PickledDog/matx-pc104/README.md

# matx-pc104
 microATX carrier board for PC/104 SBCs
