PickledDog/matx-pc104/matx-pc104.pdf

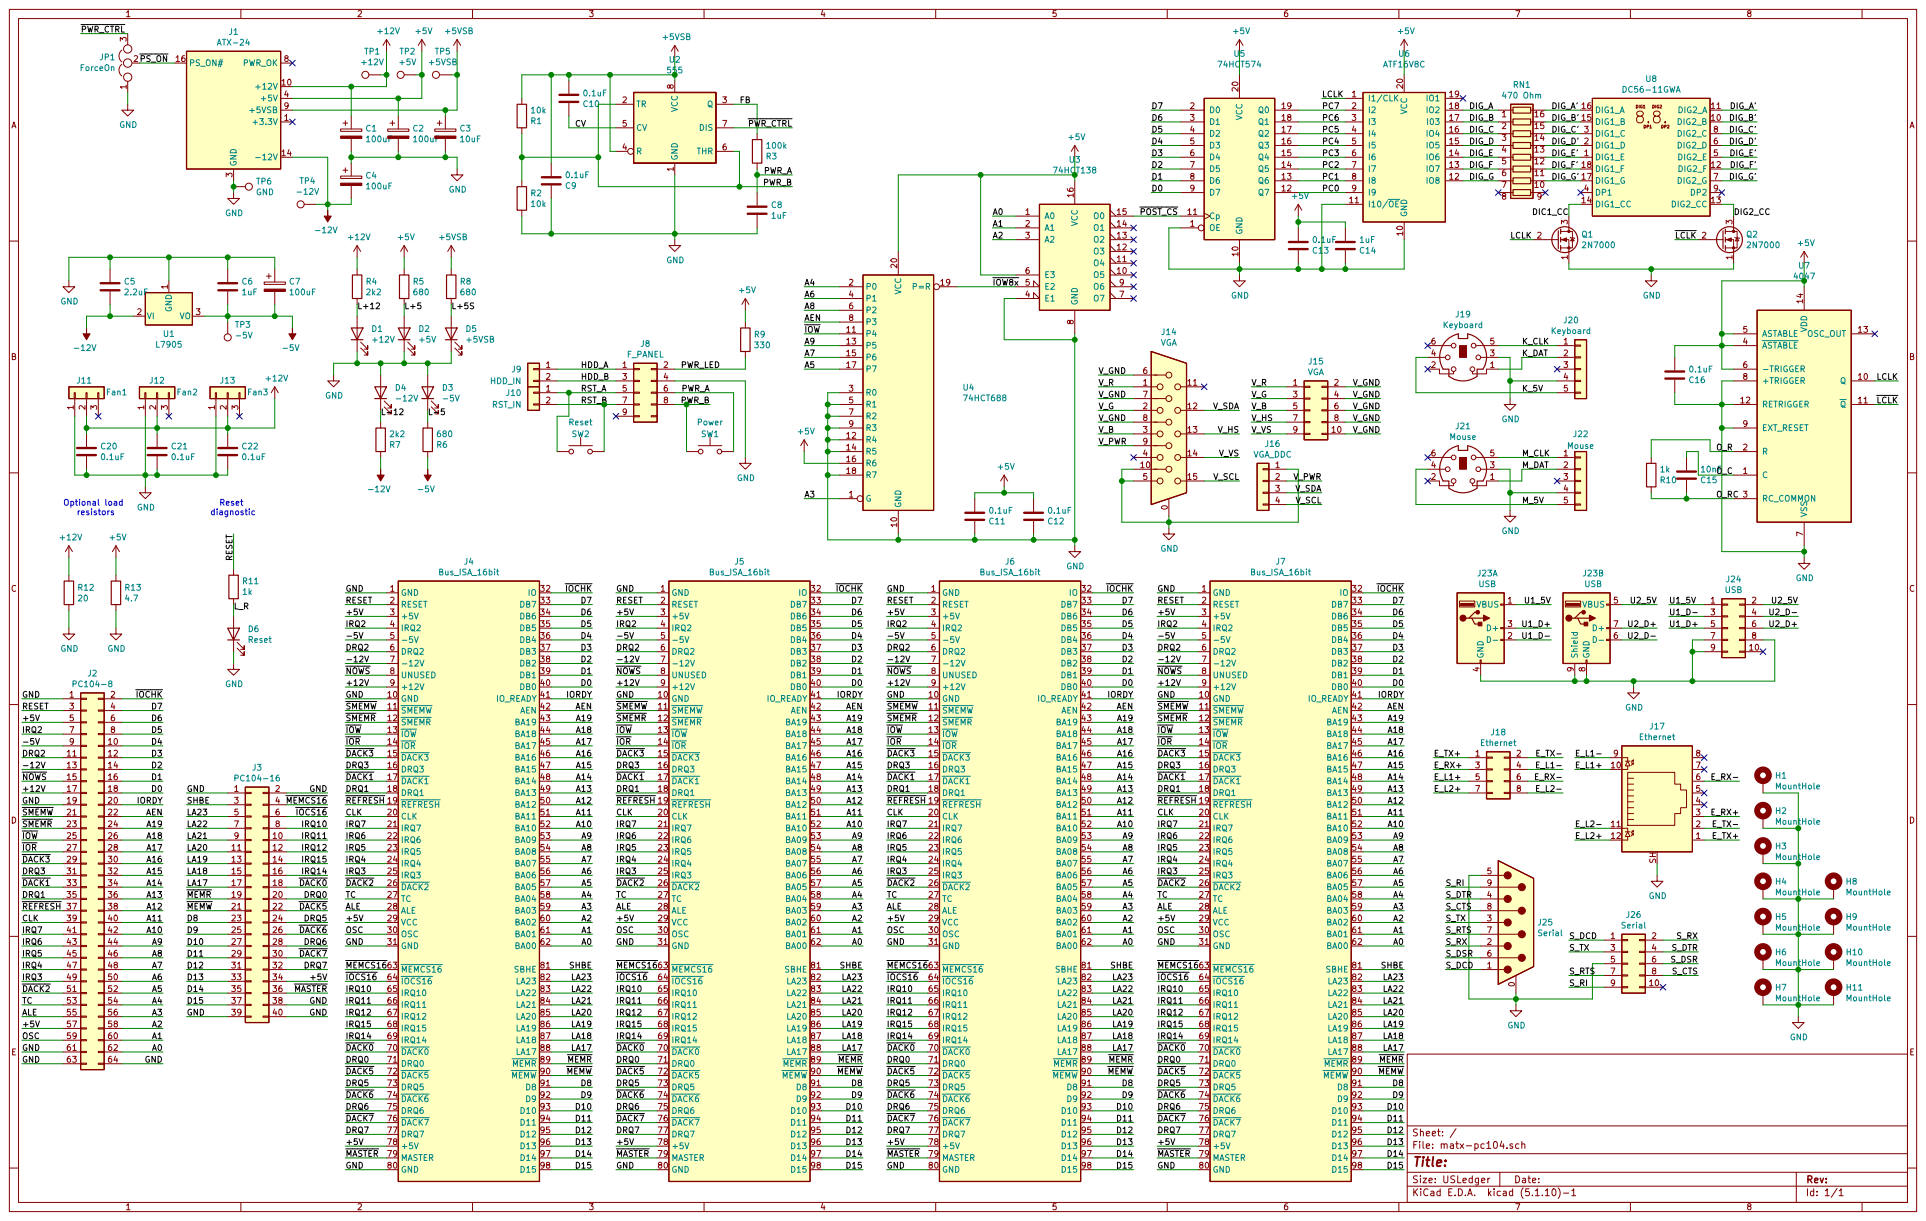
[picture p1: page 1]

IRQ3 25 DACK2 26 TC 27 ALE 28 VCC 29 +5V 3 OSC 30 GND 31

File: matx-pc104.sch Sheet: /
Id: 1/1 Title:
