PickledDog/matx-pc104/matx-pc104.kicad_pcb

## KiCad design matx-pc104.kicad_pcb (2022-07-11)

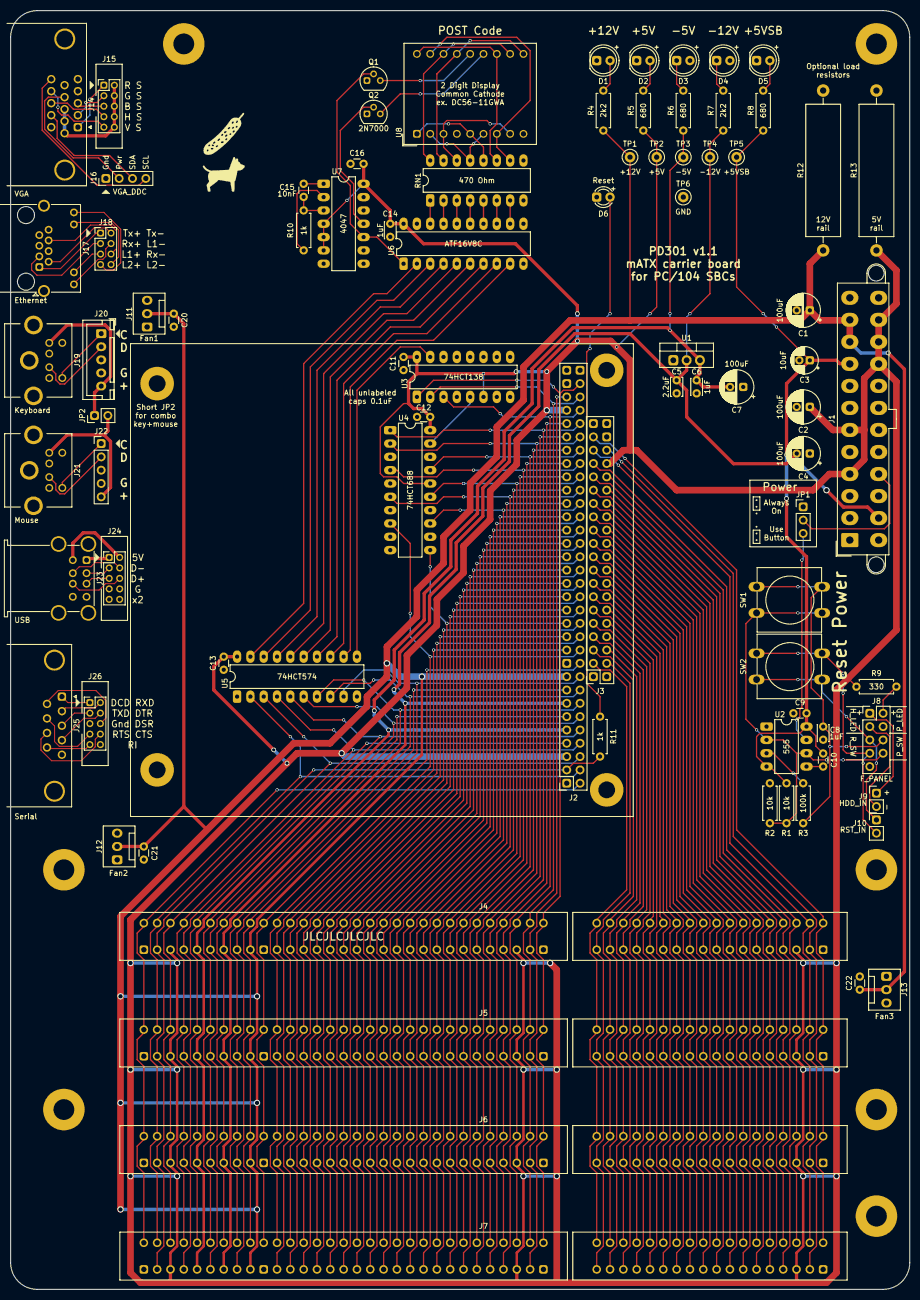
[picture p2: board matx-pc104.kicad_pcb from above]

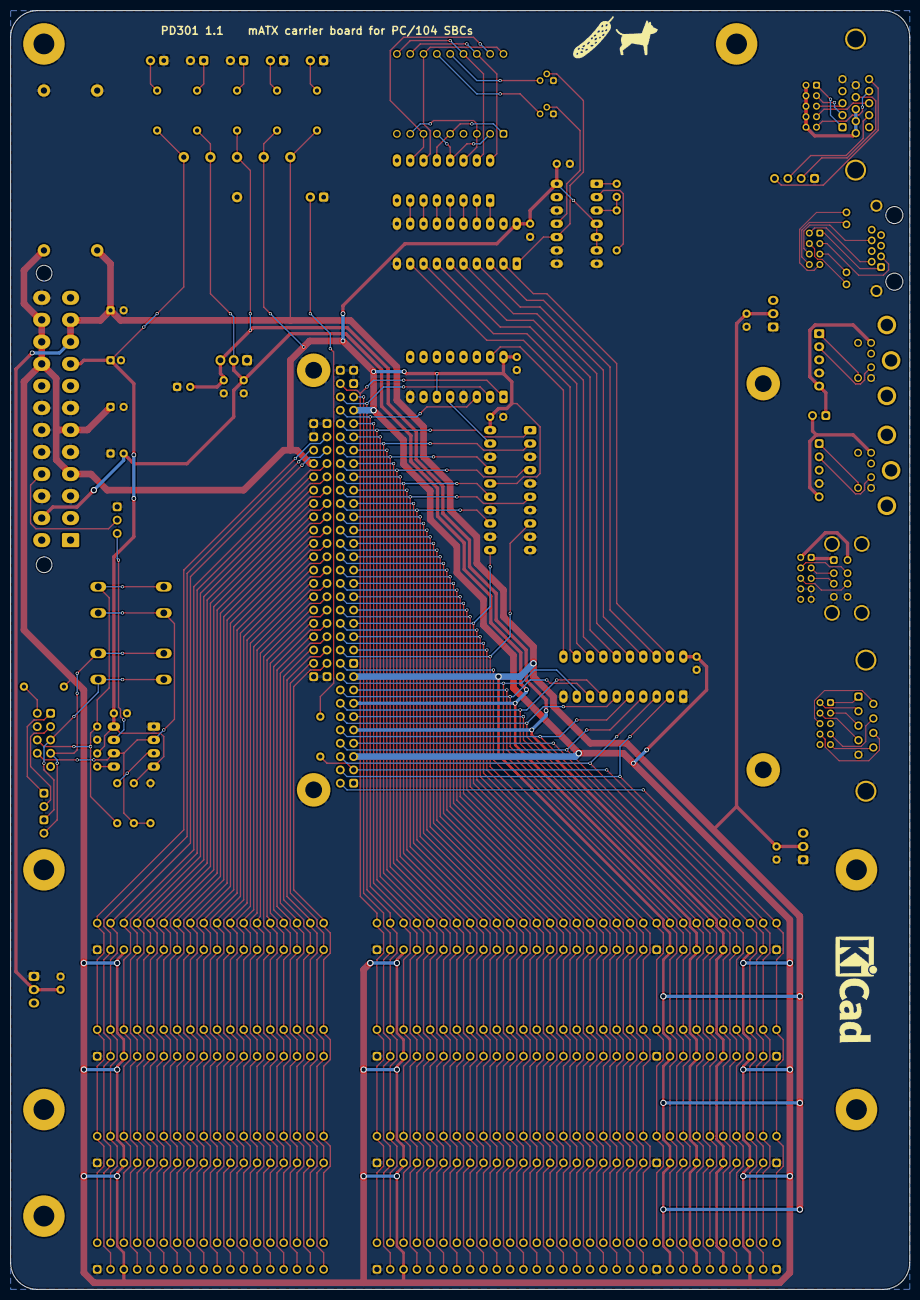
[picture p3: board matx-pc104.kicad_pcb from below]

Board: 2 copper layers, 171.4 x 243.8 mm, 100 parts (2 on the bottom side), 180 nets.

Parts:
C1, C2, C4, C7: 100uF; CP_Radial_D6.3mm_P2.50mm
C3: 10uF; CP_Radial_D5.0mm_P2.00mm
C5: 2.2uF; C_Disc_D3.4mm_W2.1mm_P2.50mm
C6, C8, C14: 1uF; C_Disc_D3.0mm_W2.0mm_P2.50mm
C9, C10, C11, C12, C13, C16, C20, C21, C22: 0.1uF; C_Disc_D3.0mm_W1.6mm_P2.50mm
C15: 10nF; C_Disc_D3.0mm_W1.6mm_P2.50mm
D1: +12V; LED_D5.0mm
D2: +5V; LED_D5.0mm
D3: -5V; LED_D5.0mm
D4: -12V; LED_D5.0mm
D5: +5VSB; LED_D5.0mm
D6: Reset; LED_D3.0mm
H1, H2, H3, H4, H5, H6, H7: MountHole; MountingHole_156mil_Pad
H8, H9, H10, H11: MountHole; MountingHole_3.2mm_M3_Pad
J1: ATX-24; Molex_Mini-Fit_Jr_5566-24A2_2x12_P4.20mm_Vertical
J2: PC104-8; PinSocket_2x32_P2.54mm_Vertical
J3: PC104-16; PinSocket_2x20_P2.54mm_Vertical
J4, J5, J6, J7: Bus_ISA_16bit; BUS_AT_Socket
J8: F_PANEL; PinHeader_2x05_P2.54mm_Vertical_Delete10
J9: HDD_IN; PinHeader_1x02_P2.54mm_Vertical
J10: RST_IN; PinHeader_1x02_P2.54mm_Vertical
J11: Fan1; FanPinHeader_1x03_P2.54mm_Vertical
J12: Fan2; FanPinHeader_1x03_P2.54mm_Vertical
J13: Fan3; FanPinHeader_1x03_P2.54mm_Vertical
J14: VGA; DSUB-15-HD_Female_Horizontal_P2.29x2.54mm_Housed
J15: VGA; PinHeader_2x05_P2.00mm_Vertical
J16: VGA_DDC; PinHeader_1x04_P2.54mm_Vertical
J17: Ethernet; RJ45_Amphenol_RJHSE538X
J18: Ethernet; PinHeader_2x04_P2.00mm_Vertical
J19: Keyboard; Mini-DIN-6-Socket
J20: Keyboard; JST_XH_B5B-XH-A_1x05_P2.50mm_Vertical
J21: Mouse; Mini-DIN-6-Socket
J22: Mouse; PinHeader_1x05_P2.54mm_Vertical
J23: USB; USB_A_Wuerth_61400826021_Horizontal_Stacked
J24: USB; PinHeader_2x05_P2.00mm_Vertical
J25: Serial; DSUB-9_Male_Horizontal_P2.77x2.84mm_EdgePinOffset7.70mm_Hou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
J26: Serial; PinHeader_2x05_P2.00mm_Vertical
JP1: ForceOn; PinHeader_1x03_P2.54mm_Vertical
JP2: K_5V=M_5V; PinHeader_1x02_P2.54mm_Vertical
Q1, Q2: 2N7000; TO-92
R1, R2: 10k; R_Axial_DIN0207_L6.3mm_D2.5mm_P7.62mm_Horizontal
R3: 100k; R_Axial_DIN0207_L6.3mm_D2.5mm_P7.62mm_Horizontal
R4, R7: 2k2; R_Axial_DIN0207_L6.3mm_D2.5mm_P7.62mm_Horizontal
R5, R6, R8: 680; R_Axial_DIN0207_L6.3mm_D2.5mm_P7.62mm_Horizontal
R9: 330; R_Axial_DIN0207_L6.3mm_D2.5mm_P7.62mm_Horizontal
R10, R11: 1k; R_Axial_DIN0207_L6.3mm_D2.5mm_P7.62mm_Horizontal
R12: 20; R_Axial_Power_L25.0mm_W6.4mm_P30.48mm
R13: 4.7; R_Axial_Power_L25.0mm_W6.4mm_P30.48mm
RN1: 470 Ohm; DIP-16_W7.62mm_LongPads
Ref**: Val**; Symbol-Dog-8mm
Ref**#2, Ref**#4: Val**; Symbol-Pickle-8mm
Ref**#3: Val**; Symbol-Dog-8mm
SW1: Power; SW_PUSH-12mm
SW2: Reset; SW_PUSH-12mm
TP1: +12V; TestPoint_Loop_D1.80mm_Drill1.0mm_Beaded
TP2: +5V; TestPoint_Loop_D1.80mm_Drill1.0mm_Beaded
TP3: -5V; TestPoint_Loop_D1.80mm_Drill1.0mm_Beaded
TP4: -12V; TestPoint_Loop_D1.80mm_Drill1.0mm_Beaded
TP5: +5VSB; TestPoint_Loop_D1.80mm_Drill1.0mm_Beaded
TP6: GND; TestPoint_Loop_D1.80mm_Drill1.0mm_Beaded
U1: L7905; TO-220-3_Vertical
U2: 555; DIP-8_W7.62mm_LongPads
U3: 74HCT138; DIP-16_W7.62mm_LongPads
U4: 74HCT688; DIP-20_W7.62mm_LongPads
U5: 74HCT574; DIP-20_W7.62mm_LongPads
U6: ATF16V8C; DIP-20_W7.62mm_LongPads
U7: 4047; DIP-14_W7.62mm_LongPads
U8: DC56-11GWA; DA56-11CGKWA

Connections:
+5V: C2.1, C11.2, C12.2, C13.2, C14.2, C16.2, J1.4, J1.6, J1.21, J1.22, J1.23, J2.5, J2.57, J3.34, J4.3, J4.29, J4.78, J5.3, J5.29, J5.78, J6.3, J6.29, J6.78, J7.3, J7.29, J7.78, R5.1, R9.1, R13.1, TP2.1, U3.6, U3.16, U4.16, U4.20, U5.20, U6.20, U7.4, U7.5, U7.6, U7.14
+5VSB: C3.1, C9.2, C10.1, J1.9, R1.2, R8.1, TP5.1, U2.4, U2.8
+12V: C1.1, C20.1, C21.1, C22.1, J1.10, J1.11, J2.17, J4.9, J5.9, J6.9, J7.9, J11.2, J12.2, J13.2, R4.1, R12.1, TP1.1
-5V: C6.2, C7.2, J2.9, J4.5, J5.5, J6.5, J7.5, R6.1, TP3.1, U1.3
-12V: C4.2, C5.2, J1.14, J2.13, J4.7, J5.7, J6.7, J7.7, R7.1, TP4.1, U1.2
/A0: J2.62, J4.62, J5.62, J6.62, J7.62, U3.1
/A1: J2.60, J4.61, J5.61, J6.61, J7.61, U3.2
/A2: J2.58, J4.60, J5.60, J6.60, J7.60, U3.3
/A3: J2.56, J4.59, J5.59, J6.59, J7.59, U4.1
/A4: J2.54, J4.58, J5.58, J6.58, J7.58, U4.2
/A5: J2.52, J4.57, J5.57, J6.57, J7.57, U4.17
/A6: J2.50, J4.56, J5.56, J6.56, J7.56, U4.4
/A7: J2.48, J4.55, J5.55, J6.55, J7.55, U4.15
/A8: J2.46, J4.54, J5.54, J6.54, J7.54, U4.6
/A9: J2.44, J4.53, J5.53, J6.53, J7.53, U4.13
/A10: J2.42, J4.52, J5.52, J6.52, J7.52
/A11: J2.40, J4.51, J5.51, J6.51, J7.51
/A12: J2.38, J4.50, J5.50, J6.50, J7.50
/A13: J2.36, J4.49, J5.49, J6.49, J7.49
/A14: J2.34, J4.48, J5.48, J6.48, J7.48
/A15: J2.32, J4.47, J5.47, J6.47, J7.47
/A16: J2.30, J4.46, J5.46, J6.46, J7.46
/A17: J2.28, J4.45, J5.45, J6.45, J7.45
/A18: J2.26, J4.44, J5.44, J6.44, J7.44
/A19: J2.24, J4.43, J5.43, J6.43, J7.43
/AEN: J2.22, J4.42, J5.42, J6.42, J7.42, U4.8
/ALE: J2.55, J4.28, J5.28, J6.28, J7.28
/CLK: J2.39, J4.20, J5.20, J6.20, J7.20
/CV: C10.2, U2.5
/D0: J2.18, J4.40, J5.40, J6.40, J7.40, U5.9
/D1: J2.16, J4.39, J5.39, J6.39, J7.39, U5.8
/D2: J2.14, J4.38, J5.38, J6.38, J7.38, U5.7
/D3: J2.12, J4.37, J5.37, J6.37, J7.37, U5.6
/D4: J2.10, J4.36, J5.36, J6.36, J7.36, U5.5
/D5: J2.8, J4.35, J5.35, J6.35, J7.35, U5.4
/D6: J2.6, J4.34, J5.34, J6.34, J7.34, U5.3
/D7: J2.4, J4.33, J5.33, J6.33, J7.33, U5.2
/D8: J3.23, J4.91, J5.91, J6.91, J7.91
/D9: J3.25, J4.92, J5.92, J6.92, J7.92
/D10: J3.27, J4.93, J5.93, J6.93, J7.93
/D11: J3.29, J4.94, J5.94, J6.94, J7.94
/D12: J3.31, J4.95, J5.95, J6.95, J7.95
/D13: J3.33, J4.96, J5.96, J6.96, J7.96
/D14: J3.35, J4.97, J5.97, J6.97, J7.97
/D15: J3.37, J4.98, J5.98, J6.98, J7.98
/DIC1_CC: Q1.3, U8.14
/DIG2_CC: Q2.3, U8.13
/DIG_A: RN1.1, U6.18
/DIG_A': RN1.16, U8.11, U8.16
/DIG_B: RN1.2, U6.17
/DIG_B': RN1.15, U8.10, U8.15
/DIG_C: RN1.3, U6.16
/DIG_C': RN1.14, U8.3, U8.8
/DIG_D: RN1.4, U6.15
/DIG_D': RN1.13, U8.2, U8.6
/DIG_E: RN1.5, U6.14
/DIG_E': RN1.12, U8.1, U8.5
/DIG_F: RN1.6, U6.13
/DIG_F': RN1.11, U8.12, U8.18
/DIG_G: RN1.7, U6.12
/DIG_G': RN1.10, U8.7, U8.17
/DRQ0: J3.20, J4.71, J5.71, J6.71, J7.71
/DRQ1: J2.35, J4.18, J5.18, J6.18, J7.18
/DRQ2: J2.11, J4.6, J5.6, J6.6, J7.6
/DRQ3: J2.31, J4.16, J5.16, J6.16, J7.16
/DRQ5: J3.24, J4.73, J5.73, J6.73, J7.73
/DRQ6: J3.28, J4.75, J5.75, J6.75, J7.75
/DRQ7: J3.32, J4.77, J5.77, J6.77, J7.77
/E_L1+: J17.10, J18.5
/E_L1-: J17.9, J18.4
/E_L2+: J17.12, J18.7
/E_L2-: J17.11, J18.8
/E_RX+: J17.3, J18.3
/E_RX-: J17.6, J18.6
/E_TX+: J17.1, J18.1
/E_TX-: J17.2, J18.2
/FB: R3.2, U2.3
/HDD_A: J8.1, J9.1
/HDD_B: J8.3, J9.2
/IORDY: J2.20, J4.41, J5.41, J6.41, J7.41
/IRQ2: J2.7, J4.4, J5.4, J6.4, J7.4
/IRQ3: J2.49, J4.25, J5.25, J6.25, J7.25
/IRQ4: J2.47, J4.24, J5.24, J6.24, J7.24
/IRQ5: J2.45, J4.23, J5.23, J6.23, J7.23
/IRQ6: J2.43, J4.22, J5.22, J6.22, J7.22
/IRQ7: J2.41, J4.21, J5.21, J6.21, J7.21
/IRQ10: J3.8, J4.65, J5.65, J6.65, J7.65
/IRQ11: J3.10, J4.66, J5.66, J6.66, J7.66
/IRQ12: J3.12, J4.67, J5.67, J6.67, J7.67
/IRQ14: J3.16, J4.69, J5.69, J6.69, J7.69
/IRQ15: J3.14, J4.68, J5.68, J6.68, J7.68
/K_5V: J19.4, J20.5, JP2.1
/K_CLK: J19.5, J20.1
/K_DAT: J19.1, J20.2
/L+5: D2.2, R5.2
/L+5S: D5.2, R8.2
/L+12: D1.2, R4.2
/L-5: D3.1, R6.2
/L-12: D4.1, R7.2
/LA17: J3.17, J4.88, J5.88, J6.88, J7.88
/LA18: J3.15, J4.87, J5.87, J6.87, J7.87
/LA19: J3.13, J4.86, J5.86, J6.86, J7.86
/LA20: J3.11, J4.85, J5.85, J6.85, J7.85
/LA21: J3.9, J4.84, J5.84, J6.84, J7.84
/LA22: J3.7, J4.83, J5.83, J6.83, J7.83
/LA23: J3.5, J4.82, J5.82, J6.82, J7.82
/LCLK: Q1.2, U6.1, U7.10
/L_R: D6.2, R11.1
/M_5V: J21.4, J22.5, JP2.2
/M_CLK: J21.5, J22.1
/M_DAT: J21.1, J22.2
/OSC: J2.59, J4.30, J5.30, J6.30, J7.30
/O_C: C15.2, U7.1
/O_R: R10.2, U7.2
/O_RC: C15.1, R10.1, U7.3
/PC0: U5.12, U6.9
/PC1: U5.13, U6.8
/PC2: U5.14, U6.7
/PC3: U5.15, U6.6
/PC4: U5.16, U6.5
/PC5: U5.17, U6.4
/PC6: U5.18, U6.3
/PC7: U5.19, U6.2
/PWR_A: C8.1, J8.6, R3.1, SW1.1
/PWR_B: J8.8, R1.1, R2.1, SW1.2, U2.2, U2.6
/PWR_LED: J8.2, R9.2
/RESET: J2.3, J4.2, J5.2, J6.2, J7.2, R11.2
/RST_A: J8.5, J10.1, SW2.2
/RST_B: J8.7, J10.2, SW2.1
/SHBE: J3.3, J4.81, J5.81, J6.81, J7.81
/S_CTS: J25.8, J26.8
/S_DCD: J25.1, J26.1
/S_DSR: J25.6, J26.6
/S_DTR: J25.4, J26.4
/S_RI: J25.9, J26.9
/S_RTS: J25.7, J26.7
/S_RX: J25.2, J26.2
/S_TX: J25.3, J26.3
/TC: J2.53, J4.27, J5.27, J6.27, J7.27
/U1_5V: J23.1, J24.1
/U1_D+: J23.3, J24.5
/U1_D-: J23.2, J24.3
/U2_5V: J23.5, J24.2
/U2_D+: J23.7, J24.6
/U2_D-: J23.6, J24.4
/V_B: J14.3, J15.5
/V_G: J14.2, J15.3
/V_GND: J14.6, J14.7, J14.8, J15.2, J15.4, J15.6, J15.8, J15.10
/V_HS: J14.13, J15.7
/V_PWR: J14.9, J16.2
/V_R: J14.1, J15.1
/V_SCL: J14.15, J16.4
/V_SDA: J14.12, J16.3
/V_VS: J14.14, J15.9
/~DACK0: J3.18, J4.70, J5.70, J6.70, J7.70
/~DACK1: J2.33, J4.17, J5.17, J6.17, J7.17
/~DACK2: J2.51, J4.26, J5.26, J6.26, J7.26
/~DACK3: J2.29, J4.15, J5.15, J6.15, J7.15
/~DACK5: J3.22, J4.72, J5.72, J6.72, J7.72
/~DACK6: J3.26, J4.74, J5.74, J6.74, J7.74
/~DACK7: J3.30, J4.76, J5.76, J6.76, J7.76
/~IOCHK: J2.2, J4.32, J5.32, J6.32, J7.32
/~IOCS16: J3.6, J4.64, J5.64, J6.64, J7.64
/~IOR: J2.27, J4.14, J5.14, J6.14, J7.14
/~IOW: J2.25, J4.13, J5.13, J6.13, J7.13, U4.11
/~IOW8x: U3.5, U4.19
/~LCLK: Q2.2, U7.11
/~MASTER: J3.36, J4.79, J5.79, J6.79, J7.79
/~MEMCS16: J3.4, J4.63, J5.63, J6.63, J7.63
/~MEMR: J3.19, J4.89, J5.89, J6.89, J7.89
/~MEMW: J3.21, J4.90, J5.90, J6.90, J7.90
/~NOWS: J2.15, J4.8, J5.8, J6.8, J7.8
/~POST_CS: U3.15, U5.11
/~PS_ON: J1.16, JP1.2
/~PWR_CTRL: JP1.3, U2.7
/~REFRESH: J2.37, J4.19, J5.19, J6.19, J7.19
/~SMEMR: J2.23, J4.12, J5.12, J6.12, J7.12
/~SMEMW: J2.21, J4.11, J5.11, J6.11, J7.11
GND: C1.2, C2.2, C3.2, C4.1, C5.1, C6.1, C7.1, C8.2, C9.1, C11.1, C12.1, C13.1, C14.1, C16.1, C20.2, C21.2, C22.2, D1.1, D2.1, D3.2, D4.2, D5.1, D6.1, H1.1, H2.1, H3.1, H4.1, H5.1, H6.1, H7.1, H8.1, H9.1, H10.1, H11.1, J1.3, J1.5, J1.7, J1.15, J1.17, J1.18, J1.19, J1.24, J2.1, J2.19, J2.61, J2.63, J2.64, J3.1, J3.2, J3.38, J3.39, J3.40, J4.1, J4.10, J4.31, J4.80, J5.1, J5.10, J5.31, J5.80, J6.1, J6.10, J6.31, J6.80, J7.1, J7.10, J7.31, J7.80, J8.4, J11.1, J12.1, J13.1, J14.0, J14.5, J14.10, J16.1, J17.SH, J19.3, J20.4, J21.3, J22.4, J23.4, J23.8, J23.9, J24.7, J24.8, J24.9, J25.0, J25.5, J26.5, JP1.1, Q1.1, Q2.1, R2.2, R12.2, R13.2, TP6.1, U1.1, U2.1, U3.4, U3.8, U4.3, U4.5, U4.7, U4.9, U4.10, U4.12, U4.14, U4.18, U5.1, U5.10, U6.10, U6.11, U7.7, U7.8, U7.9, U7.12
unnamed: J1.1, J1.2, J1.12, J1.13
