PickledDog/matx-pc104/(commit log)

2021-09-09 Initial commit of PD301 / matx-pc104
    [matx-pc104-B_Cu.gbr, matx-pc104-B_Mask.gbr, matx-pc104-B_SilkS.gbr, matx-pc104-Edge_Cuts.gbr, matx-pc104-F_Cu.gbr, matx-pc104-F_Mask.gbr, matx-pc104-F_SilkS.gbr, matx-pc104-NPTH.drl]
2021-09-11 Correct silkscreen - fix VGA pinout, align port labels
    [matx-pc104-B_Cu.gbr, matx-pc104-B_Mask.gbr, matx-pc104-B_SilkS.gbr, matx-pc104-Edge_Cuts.gbr, matx-pc104-F_Cu.gbr, matx-pc104-F_Mask.gbr, matx-pc104-F_SilkS.gbr, matx-pc104-NPTH.drl]
2021-09-20 Version 1.1. Fix reset issue
    Replace reset circuit with passthrough, increase LED decoder cap value, enlarge load resistor footprints, renumber some components
    [matx-pc104-B_Cu.gbr, matx-pc104-B_Mask.gbr, matx-pc104-B_SilkS.gbr, matx-pc104-Edge_Cuts.gbr, matx-pc104-F_Cu.gbr, matx-pc104-F_Mask.gbr, matx-pc104-F_SilkS.gbr, matx-pc104-NPTH.drl]
2021-10-10 Add silk to aid orientation of backpanel connections
    [matx-pc104-B_Cu.gbr, matx-pc104-B_Mask.gbr, matx-pc104-B_SilkS.gbr, matx-pc104-Edge_Cuts.gbr, matx-pc104-F_Cu.gbr, matx-pc104-F_Mask.gbr, matx-pc104-F_SilkS.gbr, matx-pc104-NPTH.drl]
2021-10-14 Add design for ATX I/O shield
    [backpanel-B_Cu.gbr, backpanel-B_Mask.gbr, backpanel-B_SilkS.gbr, backpanel-Edge_Cuts.gbr, backpanel-F_Cu.gbr, backpanel-F_Mask.gbr, backpanel-F_SilkS.gbr, backpanel-NPTH.drl]
2021-12-02 Adjust backpanel design for better fit
    Move Ethernet jack to be flush through backpanel, make per-port cutouts for USB
    [backpanel-B_Cu.gbr, backpanel-B_Mask.gbr, backpanel-B_SilkS.gbr, backpanel-Edge_Cuts.gbr, backpanel-F_Cu.gbr, backpanel-F_Mask.gbr, backpanel-F_SilkS.gbr, backpanel-NPTH.drl]
2022-07-11 Add jumper to link keyboard & mouse power
    [matx-pc104.kicad_pcb, matx-pc104.sch]
